Makerspace-Amiens/2026-MachineThatDraws-Groupe09/docs/index.md

---
layout: home
nav_order: 1
title: Groupe 9
permalink: /
---

# Documentation MachineThatDraws groupe 9

Bienvenue dans la documentation du projet Machine That Draws du groupe 9. Ce site a pour but de fournir toutes les informations nécessaires pour comprendre, utiliser et reproduire efficacement notre projet.

[Notre projet sur Onshape](https://cad.onshape.com/documents/f36f8aaf3489bbdbfa2a3f64/w/3f0205ef714fcd93cd075bf0/e/03979e1b762d255a4018c414){: .btn .btn-primary .fs-5 .mb-4 .mb-md-0 .mr-2 }
[Notre repo GitHub](https://github.com/Makerspace-Amiens/2026-MachineThatDraws-Groupe09/tree/main){: .btn .fs-5 .mb-4 .mb-md-0 }

<iframe height="600" width="100%" src="https://modelembedder.net/embed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" frameborder="0"></iframe>

## À propos du Projet

L'objectif de notre projet est de concevoir une machine capable de réaliser des dessins de manière autonome. Nous avons opté pour une architecture cartésienne : en utilisant un système de coordonnées basé sur des axes perpendiculaires, elle permet d'allier simplicité de construction et haute précision. 
À noter que le site a été conçu sans l'aide de l'IA. 
## Vidéo explicative et poster

Voici notre poster:

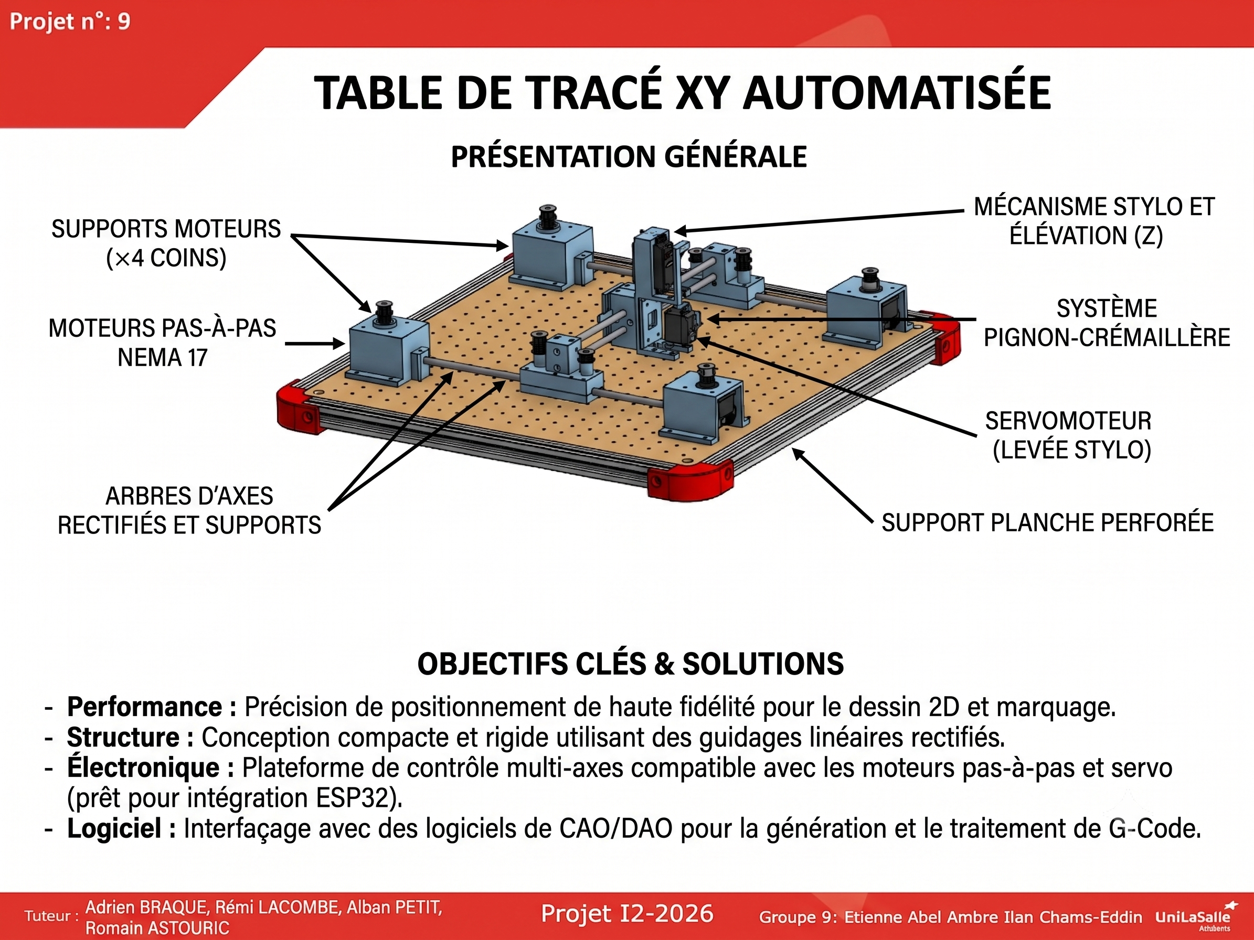
[picture p1: docs/images/post.png]
Image projet


Voici notre vidéo qui explique toute la première partie de la conception de notre machine durant le S1 :

<video width="50%" height="50%" controls>
        <source src="images/videos1.mp4" type="video/mp4" />
</video>

Voici notre vidéo de la machine finie et fonctionnelle :

[Vidéo](https://youtube.com/shorts/lLi0QcDOQ9U?feature=share)

---
