Makerspace-Amiens/2026-MachineThatDraws-Groupe09/docs/Projet Composants Programmables/pcp_1.md

---
layout: default
title: Kicad
parent: Projet composants
nav_order: 1
---

Ce projet s’inscrit dans la continuité du projet Machine That Draws qu'on a réalisé précédemment. L’objectif est de concevoir et fabriquer une carte électronique dédiée pour remplacer le contrôleur de drivers.

La carte intégrera :

- ESP32 comme microcontrôleur principal
- 2 drivers A4988 pour piloter les moteurs pas-à-pas X et Y
- Lecteur de carte SD pour stocker les fichiers G-code ou dessins
- Écran OLED pour afficher l’état, les menus et la progression
- Connecteurs pour moteurs, alimentation et extension
- Gestion des alimentations

Voici le PCB de notre carte électronique :
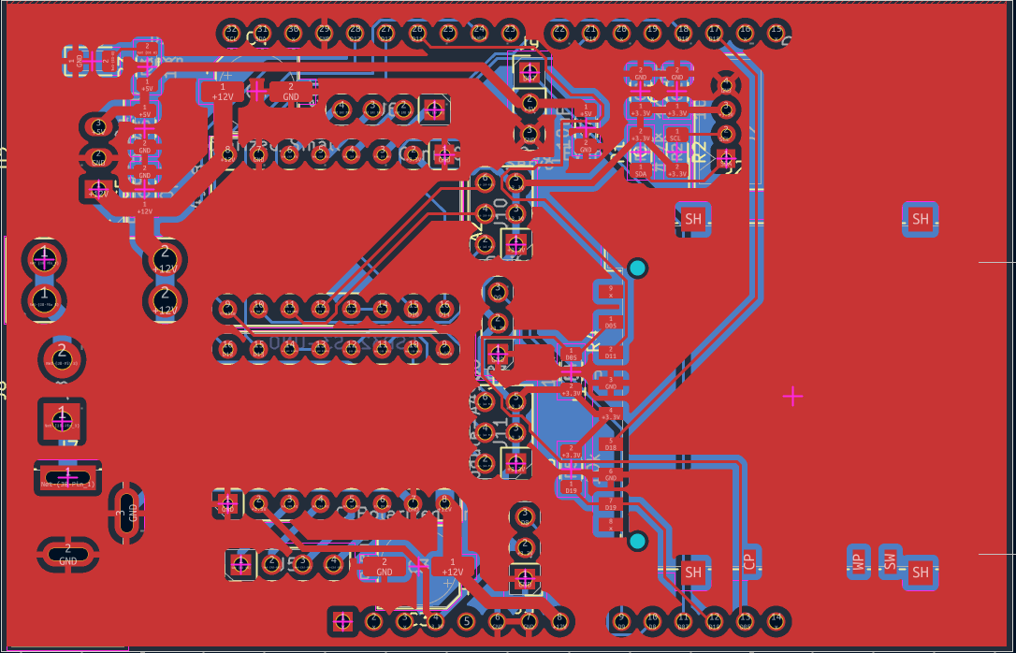
[picture p2: docs/images/pcb.png]
Image projet


Mais également le schématique :
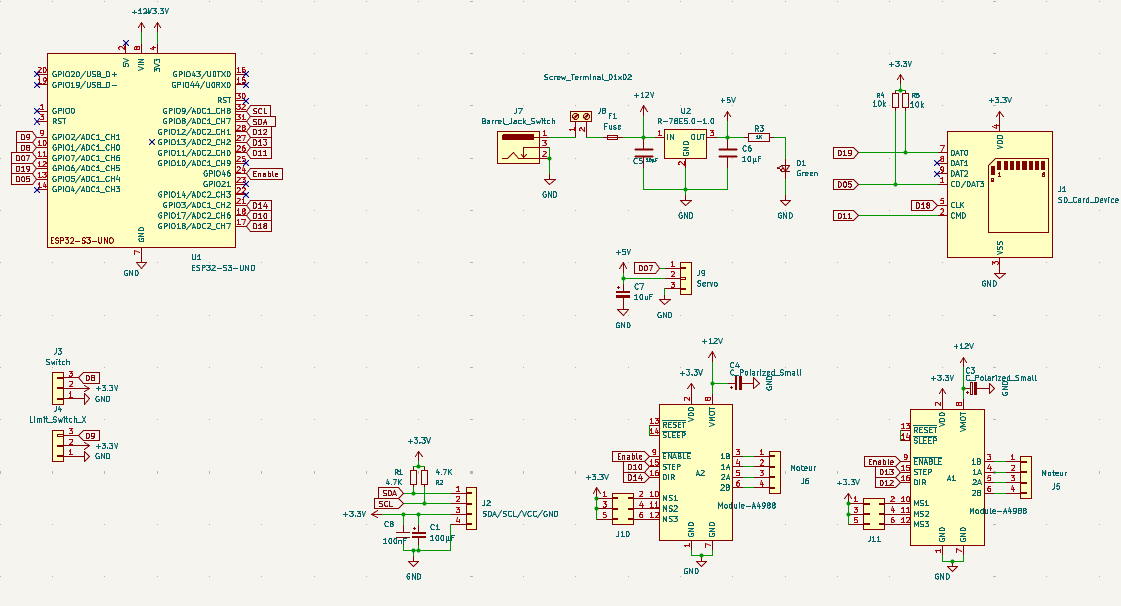
[picture p3: docs/images/shemat.png]
Image projet


Voici le test de l'écran :

<video width="50%" height="50%" controls>
        <source src="../images/videotestecrans.mp4" type="video/mp4" />
</video>

Nous avons ensuite soudé la carte :

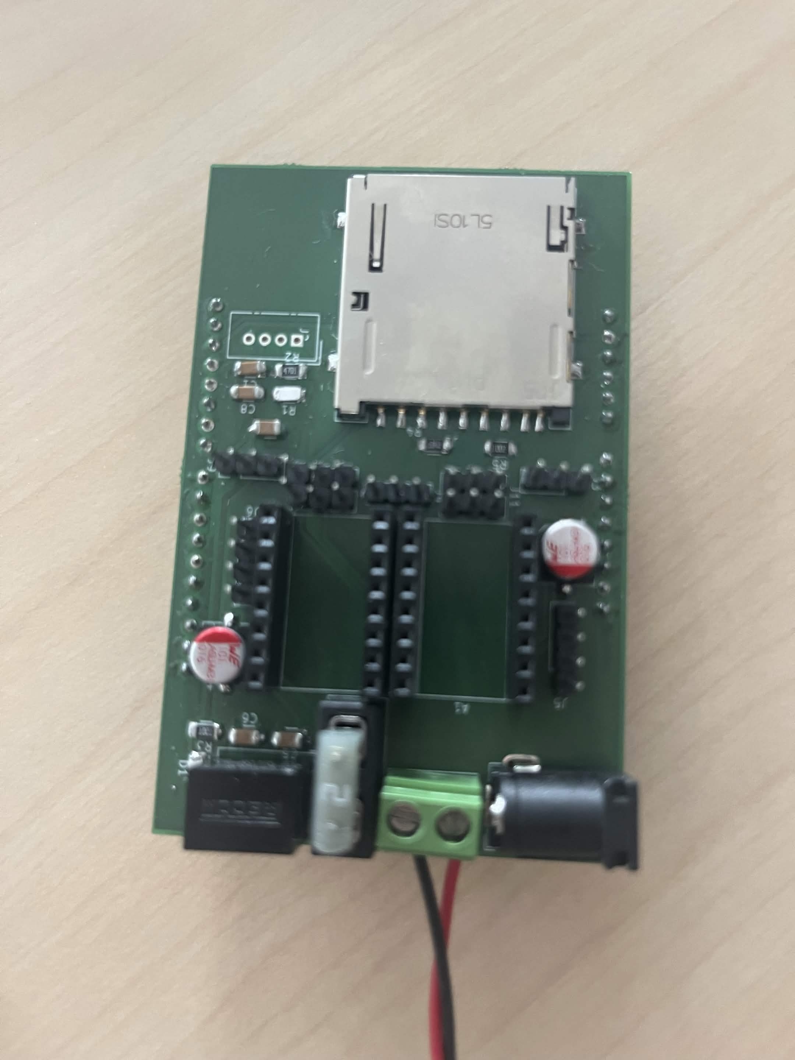
[picture p4: docs/images/carte1.jpg]
Image projet

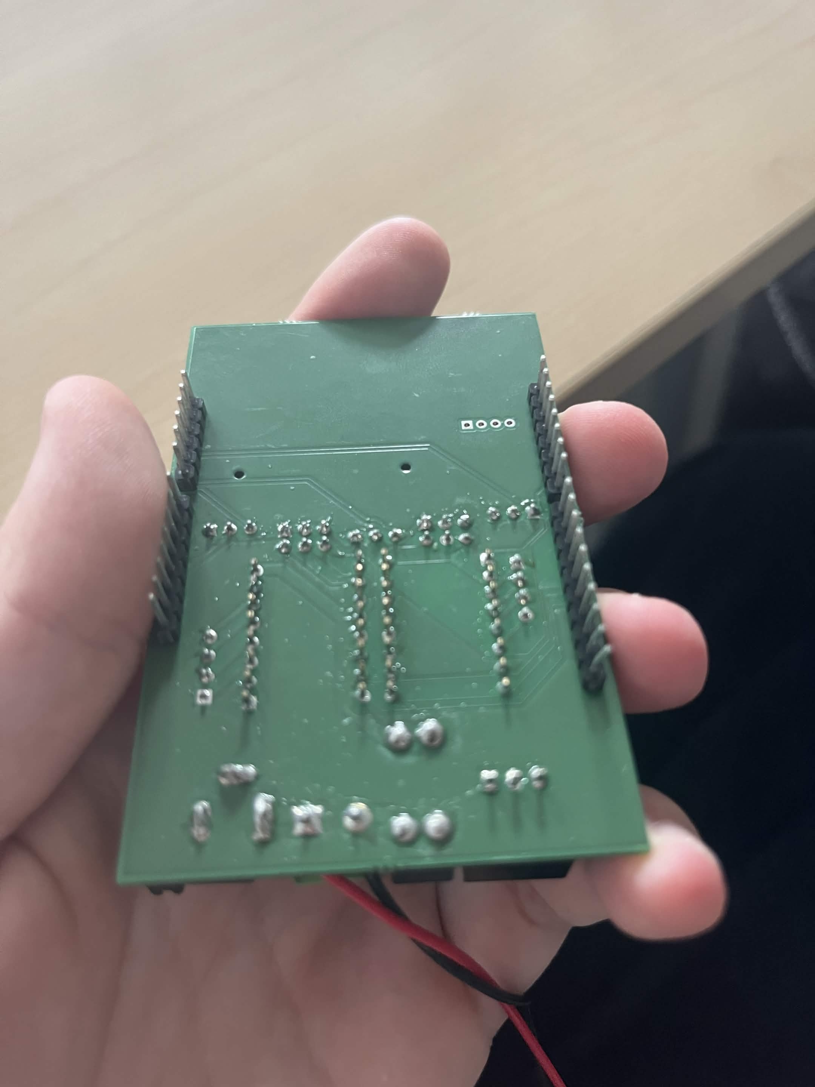
[picture p5: docs/images/carte2.jpg]
Image projet

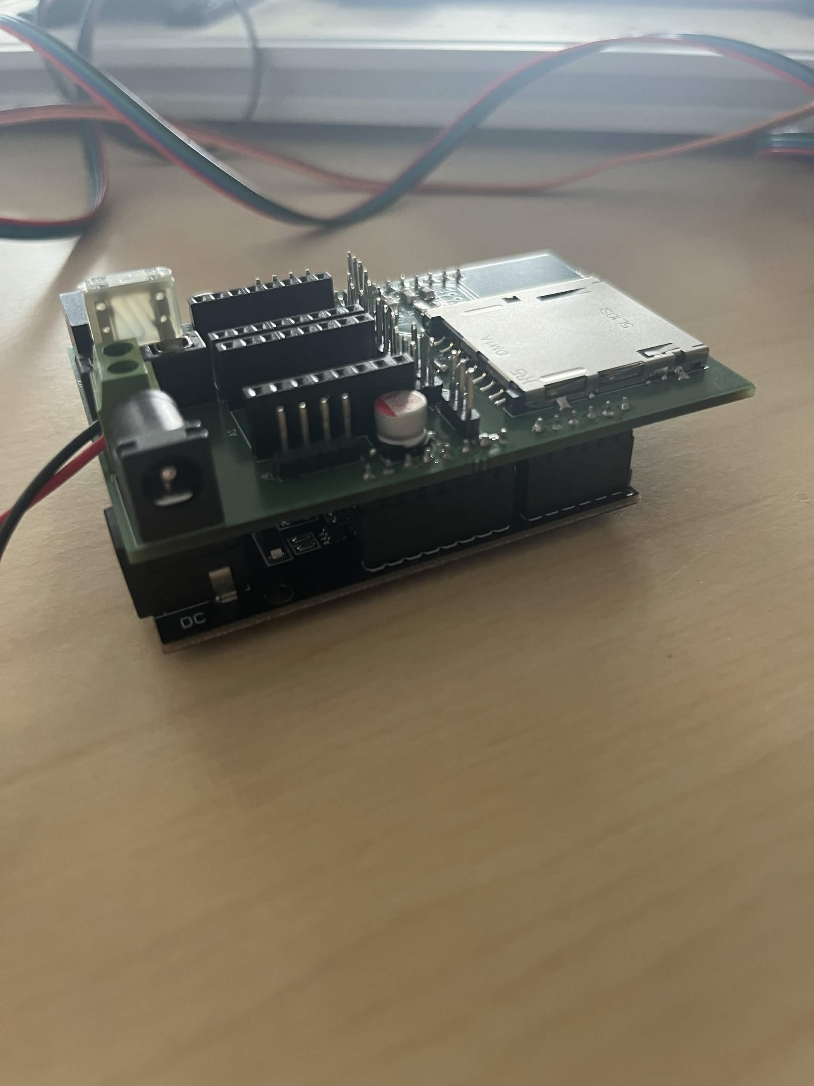
[picture p6: docs/images/carte3.jpg]
Image projet


Et nous l'avons ensuite mise sur notre machine :

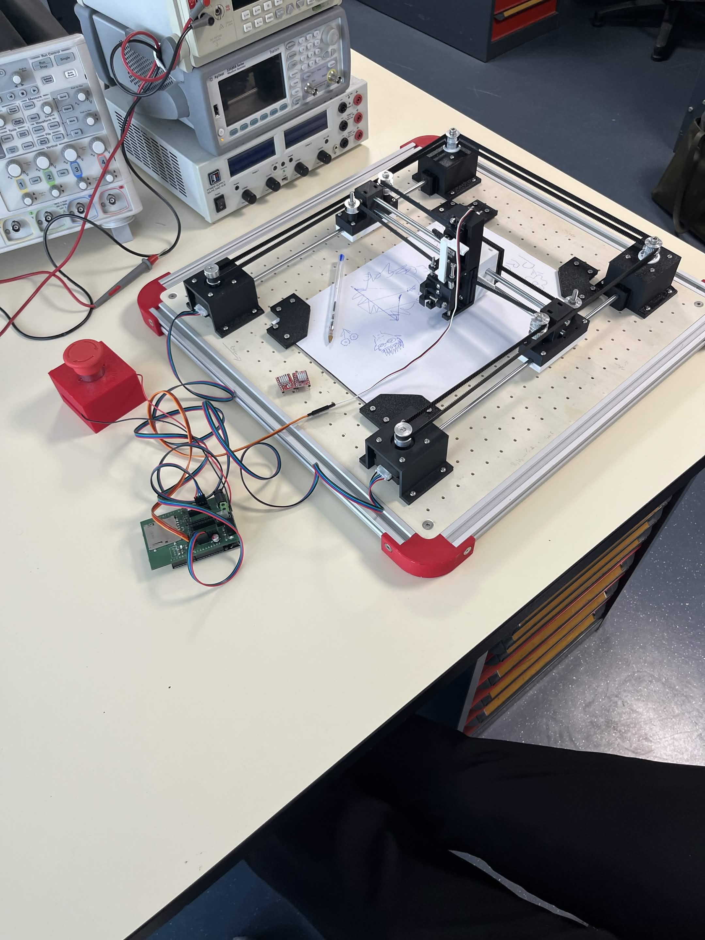
[picture p7: docs/images/carte4.jpg]
Image projet
