Makerspace-Amiens/2026-MachineThatDraws-Groupe09/docs/etapes/etape_2.md

---
layout: default
title: Assemblage
parent: Etapes de fabrication
nav_order: 2
---

# Assemblage

L'assemblage est un moment crucial, car c'est à cette étape que l'on vérifie si les pièces que nous avons modélisées s'intègrent et fonctionnent réellement bien ensemble.

## Étapes d'Assemblage

1. **Organisation** : Organisez tous les composants préparés.
2. **Assemblage Initial** : Commencez par assembler les pièces principales.
3. **Fixation** : Fixez solidement les pièces ensemble en utilisant les outils appropriés.

## Vérifications à Effectuer

- Il faut bien regarder si les courroies sont bien tendues et droites, c'est le plus important.
- Il faut vérifier la stabilité et la solidité de l'assemblage.
- Tester si les axes font une ligne droite.

## Problèmes Rencontrés et Solutions

- Problème d'alignement de la courroie : nous avons dû modifier les pièces de maintien ainsi que la hauteur de plusieurs autres composants pour la redresser.

- Fixations d'origine mal pensées : on a dû revoir et agrandir les supports. Ça nous a permis de rajouter des vis pour bien régler l'angle et être sûrs qu'elle soit parfaitement droite.

- Courroie pas assez tendue : avec ce relâchement, la machine n'en faisait qu'à sa tête et bougeait avec beaucoup moins de précision.

- Choix de la visserie : des vis à tête fraisée ont été utilisées au lieu des vis à tête bombée.

- Erreur de conception du mécanisme de levage : la pièce qui soulève le stylo avait été modélisée à l'envers. Il a fallu revoir tout le modèle pour la remettre dans le bon sens.
