Makerspace-Amiens/2026-MachineThatDraws-Groupe09/docs/etapes/etape_1.md

---
layout: default
title: Préparation des Matériaux
parent: Etapes de fabrication
nav_order: 1
---

# Préparation des Matériaux

Cette section décrit la première étape du processus de fabrication : la préparation des matériaux.

## Liste des Matériaux

- 1 planche 
- 2 moteurs
- 4 barres
  
Electronique:
- 1 Kit CNC SHIELD
- 1 Servomoteur Fitec
- 1 Câble USB Micro-B 1m
- 1 Carte MarkerUno
- 1 Alimentation 12V
- 1 Câble barret jack
- 1 switch fin de course
- 1 Stepper 17HE12-1204S
- BAU
- machine impression
- découpe laser
  
Méchanique:
- Courroie GT2 6mm - Mètre linéaire
- Pignon GT2 6mm - 20 dents - diametre 5mm
- Poulie libre GT2 6mm - 20 dents - diametre 5mm
- Arbre de guidage linéaire 6
- Bushing PTFE

---

Une fois cette étape terminée, passez à l'[Assemblage](/assemblage).
