Makerspace-Amiens/2026-MachineThatDraws-Groupe09/docs/etapes/etapes.md

---
layout: default
title: Etapes de fabrication
nav_order: 6
has_children: true
---

# Étapes de Fabrication

Bienvenue dans la section dédiée aux étapes de fabrication du projet du Core XY. Ici, vous trouverez des guides détaillés pour chaque étape du processus de fabrication.
