Makerspace-Amiens/2026-MachineThatDraws-Groupe09/project/ECAD/PCB-MachineThatDraws/PCB-MachineThatDraws.kicad_pcb

## KiCad design project/ECAD/PCB-MachineThatDraws/PCB-MachineThatDraws.kicad_pcb (2026-05-11)

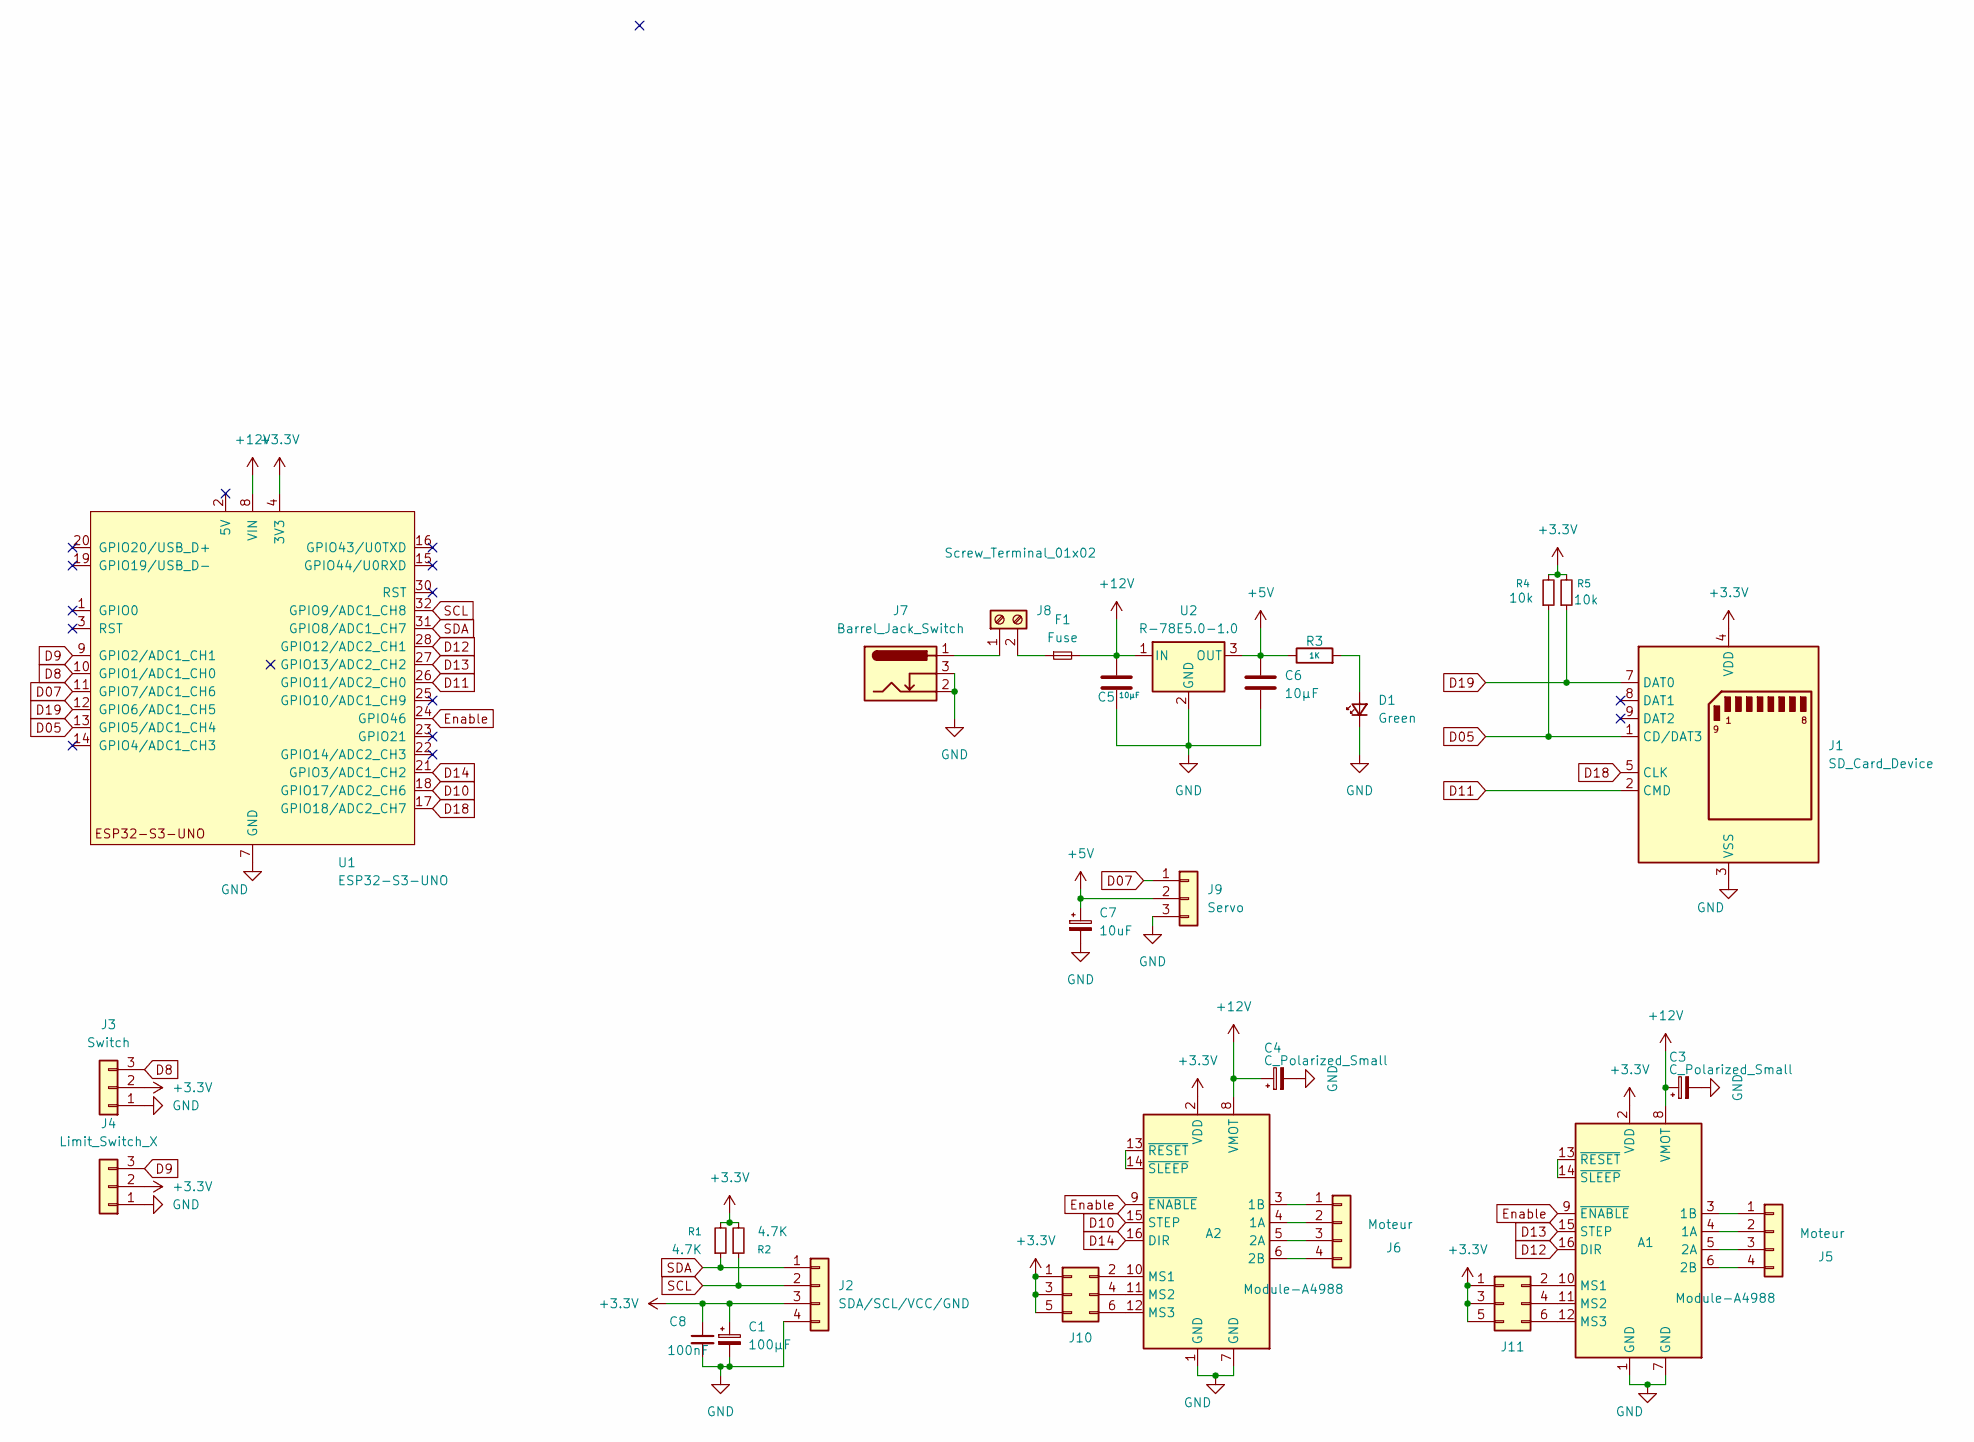
[picture p9: schematic PCB-MachineThatDraws.kicad_sch]

Parts:
A1, A2: Module-A4988; Pololu_Breakout-16_15.2x20.3mm
C1: 100µF; C_1206
C3, C4: C_Polarized_Small; CP_Elec_6.3x5.4
C5, C6: 10µF; C_1206
C7: 10uF; C_1206
C8: 100nF; C_1206
D1: Green; LED_1206_3216Metric
F1: Fuse; Fuseholder_Blade_Mini_Keystone_3568
J1: SD_Card_Device; SD_Hirose_DM1AA_SF_PEJ82
J2: SDA/SCL/VCC/GND; NS-Tech_Grove_1x04_P2mm_Vertical
J3: Switch; PinHeader_1x03_P2.54mm_Vertical
J4: Limit_Switch_X; PinHeader_1x03_P2.54mm_Vertical
J5, J6: Moteur; PinHeader_1x04_P2.54mm_Vertical
J7: Barrel_Jack_Switch; BarrelJack_GCT_DCJ200-10-A_Horizontal
J8: Screw_Terminal_01x02; TerminalBlock_bornier-2_P5.08mm
J9: Servo; PinHeader_1x03_P2.54mm_Vertical
J10, J11: Conn_02x03_Odd_Even; PinHeader_2x03_P2.54mm_Vertical
R1, R2: 4.7K; R_1206
R3: 1K; R_1206
R4, R5: 10k; R_1206
U1: ESP32-S3-UNO; ESP_S3_UNO
U2: R-78E5.0-1.0; Converter_DCDC_RECOM_R-78E-0.5_THT

Connections:
+3.3V: A1.2 (VDD), A2.2 (VDD), C1.1, C8.1, J1.4 (VDD), J2.3, J3.2, J4.2, J10.1, J10.3, J10.5, J11.1, J11.3, J11.5, R1.2, R2.2, R4.2, R5.2, U1.4 (3V3)
+5V: C6.1, C7.1, J9.2, R3.1, U2.3 (OUT)
+12V: A1.8 (VMOT), A2.8 (VMOT), C3.1, C4.1, C5.1, F1.2, U1.8 (VIN), U2.1 (IN)
D05: J1.1 (CD/DAT3), R4.1, U1.13 (GPIO5/ADC1_CH4)
D07: J9.1, U1.11 (GPIO7/ADC1_CH6)
D8: J3.3, U1.10 (GPIO1/ADC1_CH0)
D9: J4.3, U1.9 (GPIO2/ADC1_CH1)
D10: A2.15 (STEP), U1.18 (GPIO17/ADC2_CH6)
D11: J1.2 (CMD), U1.26 (GPIO11/ADC2_CH0)
D12: A1.16 (DIR), U1.28 (GPIO12/ADC2_CH1)
D13: A1.15 (STEP), U1.27 (GPIO13/ADC2_CH2)
D14: A2.16 (DIR), U1.21 (GPIO3/ADC1_CH2)
D18: J1.5 (CLK), U1.17 (GPIO18/ADC2_CH7)
D19: J1.7 (DAT0), R5.1, U1.12 (GPIO6/ADC1_CH5)
Enable: A1.9 (~ENABLE), A2.9 (~ENABLE), U1.24 (GPIO46)
GND: A1.1 (GND), A1.7 (GND), A2.1 (GND), A2.7 (GND), C1.2, C3.2, C4.2, C5.2, C6.2, C7.2, C8.2, D1.1 (K), J1.3 (VSS), J1.6 (VSS), J2.4, J3.1, J4.1, J7.2, J7.3, J9.3, U1.6 (GND), U1.7 (GND), U1.29 (GND), U2.2 (GND)
unnamed: A1.4 (1A), J5.2
unnamed: A1.3 (1B), J5.1
unnamed: A1.5 (2A), J5.3
unnamed: A1.6 (2B), J5.4
unnamed: A1.10 (MS1), J11.2
unnamed: A1.11 (MS2), J11.4
unnamed: A1.12 (MS3), J11.6
unnamed: A1.13 (~RESET), A1.14 (~SLEEP)
unnamed: A2.4 (1A), J6.2
unnamed: A2.3 (1B), J6.1
unnamed: A2.5 (2A), J6.3
unnamed: A2.6 (2B), J6.4
unnamed: A2.10 (MS1), J10.2
unnamed: A2.11 (MS2), J10.4
unnamed: A2.12 (MS3), J10.6
unnamed: A2.13 (~RESET), A2.14 (~SLEEP)
unnamed: D1.2 (A), R3.2
unnamed: J7.1, J8.1
unnamed: F1.1, J8.2
SCL: U1.32 (GPIO9/ADC1_CH8)
SCL: J2.2, R2.1
SDA: J2.1, R1.1
SDA: U1.31 (GPIO8/ADC1_CH7)

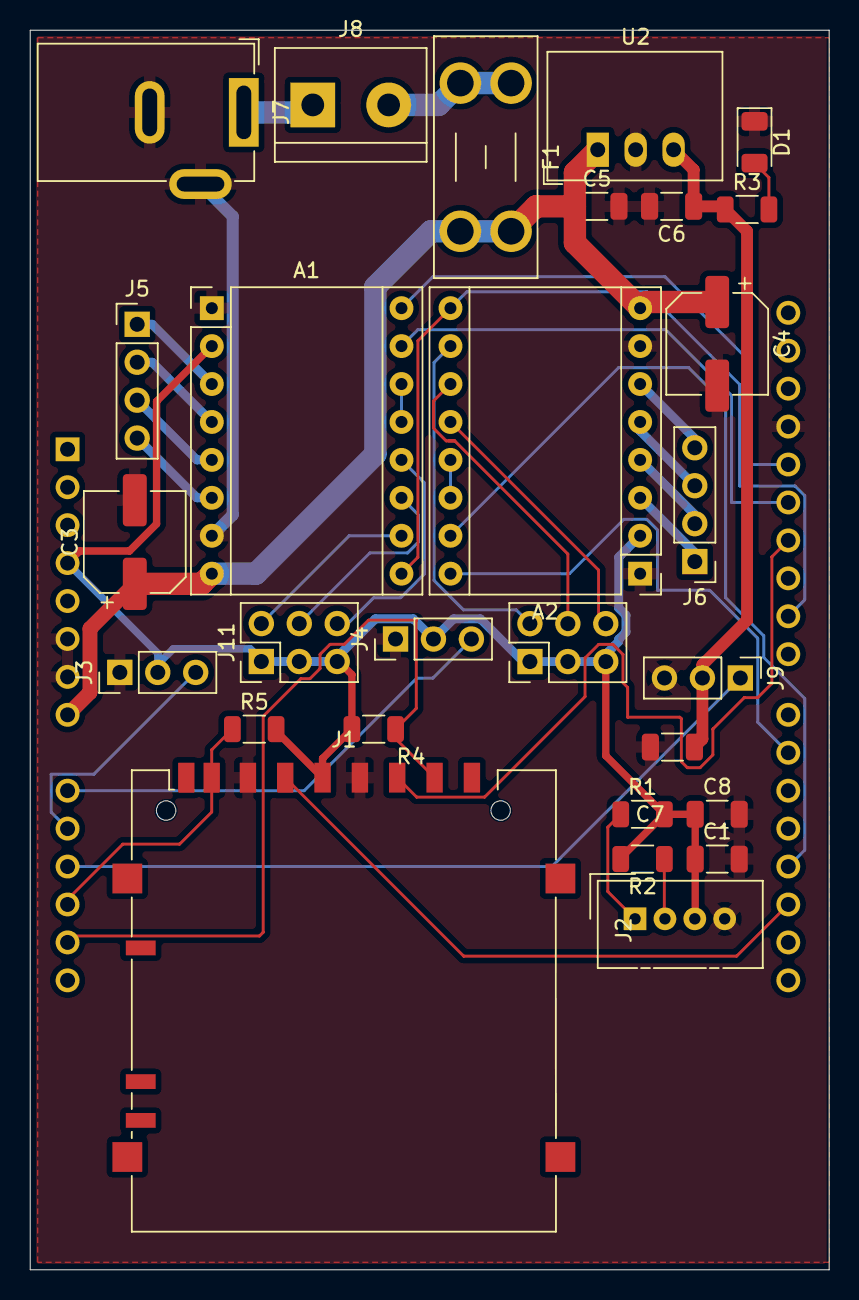
[picture p10: board PCB-MachineThatDraws.kicad_pcb from above]

Board: 2 copper layers, 53.5 x 83.0 mm, 29 parts (0 on the bottom side), 37 nets.
