Makerspace-Amiens/2026-MachineThatDraws-Groupe09/(commit log)

2026-04-27 Rename PCB-MachineThatDraws v2.kicad_pcb to PCB-MachineThatDraws.kicad_pcb
    [PCB-MachineThatDraws.kicad_pcb]
2026-04-27 pcb up
    [PCB-MachineThatDraws.kicad_pcb, PCB-MachineThatDraws.kicad_sch]
2026-05-06 pcb + sch up
    [PCB-MachineThatDraws.kicad_pcb, PCB-MachineThatDraws.kicad_sch]
2026-05-06 pcb opti
    [PCB-MachineThatDraws.kicad_pcb]
2026-05-06 pcb up, 0 erreurs au drc
    [PCB-MachineThatDraws.kicad_pcb]
2026-05-11 pcb correction
    [PCB-MachineThatDraws.kicad_pcb, PCB-MachineThatDraws.kicad_sch]
2026-05-22 Create Capture d’écran 2026-05-22 à 13.40.58.png
2026-06-04 truc de chose
